wmdscjhdpy/SmartCar/README.md

# SmartCar
a project for a small intelligence Robot Car
