wmdscjhdpy/SmartCar/Doc/功能需求.docx

视觉：

边缘检测

人脸识别

判断车辆是否运行

判断摄像头是否有异物

简单的指点避障
