wmdscjhdpy/SmartCar/Doc/炸穿记录1.png

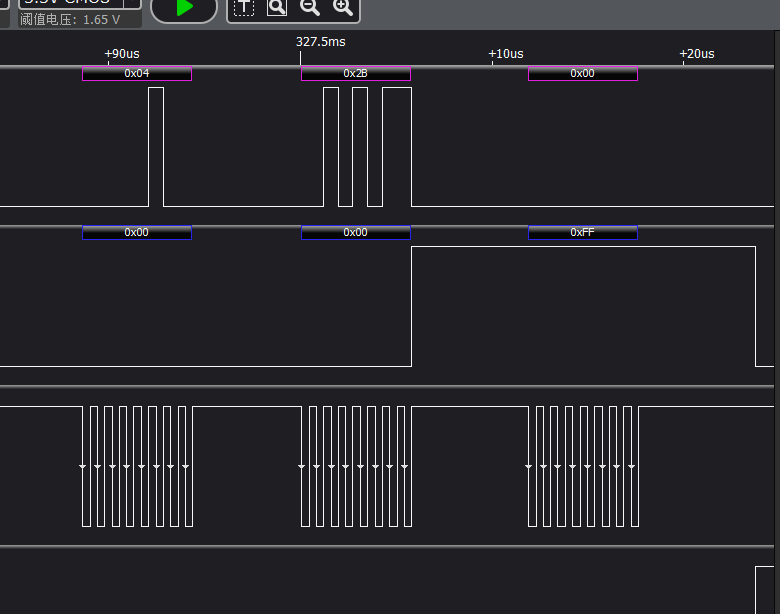
Doc/炸穿记录1.png
