wmdscjhdpy/SmartCar/Doc/SRT/oled大致模型.SLDPRT

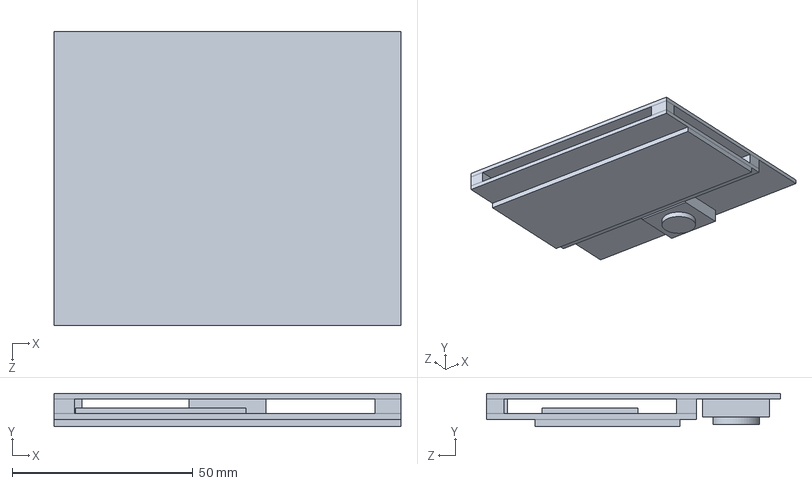
[picture p2: CAD file, 2019-03-22]
Doc/SRT/oled大致模型.SLDPRT
95.9 x 9.20 x 81.4 mm
