wmdscjhdpy/SmartCar/(list of files, drawings)

Other design files:
Doc/SRT/OLED&OPENMV.SchDoc
Doc/SRT/SRT.PrjPcb
Doc/SRT/主控.SchDoc
Doc/SRT/其他.SchDoc
Doc/SRT/电机,舵机.SchDoc
Doc/SRT/电机驱动.SchDoc
Doc/SRT/电源.SchDoc
Doc/SRT/语音合成.SchDoc
Doc/SRT/语音识别.SchDoc
