wmdscjhdpy/SmartCar/SmartCar.ioc

Mcu.UserName=STM32F405RGTx
PA0-WKUP.GPIO_Label=SIM_UART_TX
PA0-WKUP.Signal=GPIO_Output
PA1.GPIO_Label=SIM_UART_RX
PA1.Signal=GPIO_Input
PA13.Signal=SYS_JTMS-SWDIO
PA14.Signal=SYS_JTCK-SWCLK
PA15.GPIO_Label=LED4
PA15.Signal=GPIO_Output
PA2.GPIO_Label=STEERING1
PA2.Signal=S_TIM5_CH3
PA3.GPIO_Label=STEERING2
PA3.Signal=S_TIM5_CH4
PA4.GPIO_Label=SPI_NSS
PA4.Signal=GPIO_Output
PA5.Signal=SPI1_SCK
PA6.Signal=SPI1_MISO
PA7.Signal=SPI1_MOSI
PA8.Signal=S_TIM1_CH1
PA9.Signal=S_TIM1_CH2
PB0.Signal=S_TIM3_CH3
PB1.Signal=S_TIM3_CH4
PB3.GPIO_Label=SB_RST
PB3.Signal=GPIO_Output
PB5.GPIO_Label=BUSY
PB5.Signal=GPIO_Input
PB6.Signal=USART1_TX
PB7.Signal=USART1_RX
PB8.GPIO_Label=LED3
PB8.Signal=GPIO_Output
PC1.GPIO_Label=V_ADC
PC1.Signal=ADCx_IN11
PC10.Signal=USART3_TX
PC11.Signal=USART3_RX
PC12.GPIO_Label=IIC_SCL
PC12.Signal=GPIO_Output
PC13-ANTI_TAMP.GPIO_Label=LED1
PC13-ANTI_TAMP.Signal=GPIO_Output
PC14-OSC32_IN.GPIO_Label=LED2
PC14-OSC32_IN.Signal=GPIO_Output
PC2.GPIO_Label=ST_ADC1
PC2.Signal=ADCx_IN12
PC3.GPIO_Label=ST_ADC2
PC3.Signal=ADCx_IN13
PC4.GPIO_Label=LD_WR
PC4.Signal=GPIO_Output
PC6.Signal=S_TIM3_CH1
PC7.Signal=S_TIM3_CH2
PC8.Signal=S_TIM8_CH3
PC9.Signal=S_TIM8_CH4
PD2.GPIO_Label=IIC_SDA
PD2.Signal=GPIO_Output
PH0-OSC_IN.Signal=RCC_OSC_IN
PH1-OSC_OUT.Signal=RCC_OSC_OUT
