wmdscjhdpy/SmartCar/Inc/main.h

#define LED1_Pin GPIO_PIN_13
#define LED1_GPIO_Port GPIOC
#define LED2_Pin GPIO_PIN_14
#define LED2_GPIO_Port GPIOC
#define V_ADC_Pin GPIO_PIN_1
#define V_ADC_GPIO_Port GPIOC
#define ST_ADC1_Pin GPIO_PIN_2
#define ST_ADC1_GPIO_Port GPIOC
#define ST_ADC2_Pin GPIO_PIN_3
#define ST_ADC2_GPIO_Port GPIOC
#define SIM_UART_TX_Pin GPIO_PIN_0
#define SIM_UART_TX_GPIO_Port GPIOA
#define SIM_UART_RX_Pin GPIO_PIN_1
#define SIM_UART_RX_GPIO_Port GPIOA
#define STEERING1_Pin GPIO_PIN_2
#define STEERING1_GPIO_Port GPIOA
#define STEERING2_Pin GPIO_PIN_3
#define STEERING2_GPIO_Port GPIOA
#define SPI_NSS_Pin GPIO_PIN_4
#define SPI_NSS_GPIO_Port GPIOA
#define LD_WR_Pin GPIO_PIN_4
#define LD_WR_GPIO_Port GPIOC
#define LED4_Pin GPIO_PIN_15
#define LED4_GPIO_Port GPIOA
#define IIC_SCL_Pin GPIO_PIN_12
#define IIC_SCL_GPIO_Port GPIOC
#define IIC_SDA_Pin GPIO_PIN_2
#define IIC_SDA_GPIO_Port GPIOD
#define SB_RST_Pin GPIO_PIN_3
#define SB_RST_GPIO_Port GPIOB
#define BUSY_Pin GPIO_PIN_5
#define BUSY_GPIO_Port GPIOB
#define LED3_Pin GPIO_PIN_8
#define LED3_GPIO_Port GPIOB
