wmdscjhdpy/SmartCar/MyDrv/LD_Driver/LDChip.c

/***************************乐声电子科技有限公司****************************
**  文件名称：语音模块底层驱动
**	CPU: STM32f103RCT6
**	晶振：8MHZ
**	波特率：9600 bit/S
**	配套产品信息：YS-V0.4语音识别开发板
**                http://yuesheng001.taobao.com
**  作者：zdings
**  联系：751956552@qq.com
**  修改日期：2012.4.11
**  说明：本程序 具备语音识别、串口通信、开发板基本功能演示。
***************************乐声电子科技有限公司******************************/
#include "bsp.h"
#include "LDchip.h"
#include "Reg_RW.h"
#include "cmsis_os.h"
uint8_t nLD_Mode = LD_MODE_IDLE;		//	用来记录当前是在进行ASR识别还是在播放MP3
uint8_t nAsrStatus=0;	
uint8_t ucRegVal;


/***********************************************************
* 名    称：void LD_reset(void)
* 功    能：LD芯片硬件初始化
* 入口参数：  
* 出口参数：
* 说    明：因为硬件接口没有引出RST引脚，因此不能软件复位
* 调用方法： 
**********************************************************/ 
void LD_reset(void)
{
    LD_RST_H();
	LD3320_delay(100);
    LD_RST_L();
	LD3320_delay(100);
    LD_RST_H();
	LD3320_delay(100);
	LD_CS_L();
	LD3320_delay(100);
	LD_CS_H();		
	LD3320_delay(100);
}

/***********************************************************
* 名    称： void LD_Init_Common(void)
* 功    能： 初始化命令
* 入口参数：  
* 出口参数：
* 说    明：
* 调用方法： 
**********************************************************/ 
void LD_Init_Common(void)
{

	LD_ReadReg(0x06);  
	LD_WriteReg(0x17, 0x35); 
	LD3320_delay(5);
	LD_ReadReg(0x06);  

	LD_WriteReg(0x89, 0x03);  
	LD3320_delay(5);
	LD_WriteReg(0xCF, 0x43);   
	LD3320_delay(5);
	LD_WriteReg(0xCB, 0x02);
	
	/*PLL setting*/
	LD_WriteReg(0x11, LD_PLL_11);       
	if (nLD_Mode == LD_MODE_MP3)
	{
		LD_WriteReg(0x1E, 0x00); 
		LD_WriteReg(0x19, LD_PLL_MP3_19);   
		LD_WriteReg(0x1B, LD_PLL_MP3_1B);   
		LD_WriteReg(0x1D, LD_PLL_MP3_1D);
	}
	else
	{
		LD_WriteReg(0x1E,0x00);
		LD_WriteReg(0x19, LD_PLL_ASR_19); 
		LD_WriteReg(0x1B, LD_PLL_ASR_1B);		
	    LD_WriteReg(0x1D, LD_PLL_ASR_1D);
	}
	LD3320_delay(5);
	
	LD_WriteReg(0xCD, 0x04);
	LD_WriteReg(0x17, 0x4c); 
	LD3320_delay(1);
	LD_WriteReg(0xB9, 0x00);
	LD_WriteReg(0xCF, 0x4F); 
	LD_WriteReg(0x6F, 0xFF); 
}

/***********************************************************
* 名    称：void LD_Init_ASR(void)
* 功    能：初始化ASR
* 入口参数：  
* 出口参数：
* 说    明：
* 调用方法： 
**********************************************************/ 	
void LD_Init_ASR(void)
{
	nLD_Mode=LD_MODE_ASR_RUN;
	LD_Init_Common();

	LD_WriteReg(0xBD, 0x00);
	LD_WriteReg(0x17, 0x48);	
	LD3320_delay( 5 );
	LD_WriteReg(0x3C, 0x80);    
	LD_WriteReg(0x3E, 0x07);
	LD_WriteReg(0x38, 0xff);    
	LD_WriteReg(0x3A, 0x07);
	LD_WriteReg(0x40, 0);          
	LD_WriteReg(0x42, 8);
	LD_WriteReg(0x44, 0);    
	LD_WriteReg(0x46, 8); 
	LD3320_delay( 1 );
}

/***********************************************************
* 名    称：void ProcessInt0(void)
* 功    能：识别处理函数
* 入口参数：  
* 出口参数：
* 说    明：可以利用查询方式，或中断方式进行调用
* 调用方法： 
**********************************************************/ 
void ProcessInt0(void)
{
	uint8_t nAsrResCount=0;
    uint32_t ScanTime=HAL_GetTick();
    while(1)
    {
        
        if(nAsrStatus==LD_ASR_NONE)return;//还没有启动语音识别，就不存在识别了
        ucRegVal = LD_ReadReg(0x2B);

        // 语音识别产生的中断
        // （有声音输入，不论识别成功或失败都有中断）
        LD_WriteReg(0x29,0) ;
        LD_WriteReg(0x02,0) ;
        if((ucRegVal & 0x10) && LD_ReadReg(0xb2)==0x21 && LD_ReadReg(0xbf)==0x35)		
        {	 
            nAsrResCount = LD_ReadReg(0xba);

            if(nAsrResCount>0 && nAsrResCount<=4) 
            {
                nAsrStatus=LD_ASR_FOUNDOK; 		
                break;
            }
            else
            {
                nAsrStatus=LD_ASR_FOUNDZERO;
                if(HAL_GetTick()-ScanTime>2000)
                {
                    nAsrStatus=LD_ASR_NONE;
                    return;
                }
                osDelay(100);
            }	
        }
        else
         {
                nAsrStatus=LD_ASR_FOUNDZERO;	//执行没有识别
                osDelay(100);
        }
    }
		  LD_WriteReg(0x2b, 0);
		  LD_WriteReg(0x1C,0);/*写0:ADC不可用*/
		
			LD_WriteReg(0x29,0) ;
			LD_WriteReg(0x02,0) ;
			LD_WriteReg(0x2B,  0);
			LD_WriteReg(0xBA, 0);	
			LD_WriteReg(0xBC,0);	
			LD_WriteReg(0x08,1);	 /*清除FIFO_DATA*/
			LD_WriteReg(0x08,0);	/*清除FIFO_DATA后 再次写0*/

			//LD3320_delay(1);

}

/***********************************************************
* 名    称：uint8_t LD_Check_ASRBusyFlag_b2(void)
* 功    能：检测 ASR 是否忙状态
* 入口参数：flag ---1：空闲状态  
* 出口参数：
* 说    明：
* 调用方法： 
**********************************************************/ 
uint8_t LD_Check_ASRBusyFlag_b2(void)
{
	uint8_t j;
	uint8_t flag = 0;
	for (j=0; j<10; j++)
	{
		if (LD_ReadReg(0xb2) == 0x21)
		{
			flag = 1;
			break;
		}
		LD3320_delay(10);		
	}
	return flag;
}
/***********************************************************
* 名    称： void LD_AsrStart(void)
* 功    能：
* 入口参数：  ASR初始化
* 出口参数：
* 说    明：
* 调用方法： 
**********************************************************/ 
void LD_AsrStart(void)
{
	LD_Init_ASR();
}
/***********************************************************
* 名    称： uint8_t LD_AsrRun(void)
* 功    能： ASR底层执行函数 
* 入口参数：  
* 出口参数：
* 说    明：
* 调用方法： 
**********************************************************/ 
uint8_t LD_AsrRun(void)
{
	LD_WriteReg(0x35, MIC_VOL);
	LD_WriteReg(0x1C, 0x09);
	LD_WriteReg(0xBD, 0x20);
	LD_WriteReg(0x08, 0x01);
	LD3320_delay( 5 );
	LD_WriteReg(0x08, 0x00);
	LD3320_delay( 5);

	if(LD_Check_ASRBusyFlag_b2() == 0)
	{
		return 0;
	}

	LD_WriteReg(0xB2, 0xff);	
	LD_WriteReg(0x37, 0x06);
	LD_WriteReg(0x37, 0x06);
	LD3320_delay( 5);
	LD_WriteReg(0x1C, 0x0b);
	LD_WriteReg(0x29, 0x10);
	
	LD_WriteReg(0xBD, 0x00);   
	return 1;
}

/***********************************************************
* 名    称：uint8_t LD_AsrAddFixed(void)
* 功    能：添加识别关键词语
* 入口参数：  
* 出口参数： flag-- 1：success
* 说    明：开发者可以学习"语音识别芯片LD3320高阶秘籍.pdf"中
						关于垃圾词语吸收错误的用法，提高识别率。
* 调用方法： 
**********************************************************/ 
uint8_t LD_AsrAddFixed(void)
{
	uint8_t k, flag;
	uint8_t nAsrAddLength;
	#define DATE_A 4        /*数组二维数值*/
	#define DATE_B 20		/*数组一维数值*/
	 uint8_t  sRecog[DATE_A][DATE_B] = {
                                    "feng shuo",\
                                    "kai deng",\
                                    "guan deng",\
                                    "quan mie"\
                                    };	/*添加关键词，用户修改*/
	 uint8_t  pCode[DATE_A] = {
                                        CODE_CMD,\
                                        CODE_KD,\
                                         CODE_GD,\
                                          CODE_QM\
                                    };	/*添加识别码，用户修改*/
	flag = 1;
	for (k=0; k<DATE_A; k++)
	{			
		if(LD_Check_ASRBusyFlag_b2() == 0)
		{
			flag = 0;
			break;
		}
		
		LD_WriteReg(0xc1, pCode[k] );
		LD_WriteReg(0xc3, 0 );
		LD_WriteReg(0x08, 0x04);
		LD3320_delay(1);
		LD_WriteReg(0x08, 0x00);
		LD3320_delay(1);

		for (nAsrAddLength=0; nAsrAddLength<DATE_B; nAsrAddLength++)
		{
			if (sRecog[k][nAsrAddLength] == 0)
				break;
			LD_WriteReg(0x5, sRecog[k][nAsrAddLength]);
		}
		LD_WriteReg(0xb9, nAsrAddLength);
		LD_WriteReg(0xb2, 0xff);
		LD_WriteReg(0x37, 0x04);
//		LD_WriteReg(0x37, 0x04);
	}	 

    return flag;
}

/***********************************************************
* 名    称： uint8_t LD_GetResult(void)
* 功    能： 获取识别结果
* 入口参数：  
* 出口参数： 返回识别码 LD_ReadReg(0xc5 );
* 说    明：
* 调用方法： 
**********************************************************/ 
uint8_t LD_GetResult(void)
{
	return LD_ReadReg(0xc5 );
}



/***********************************************************
* 名    称：	RunASR(void)
* 功    能：	运行ASR
* 入口参数：  
* 出口参数：
* 说    明：
* 调用方法： 
**********************************************************/ 
uint8_t RunASR(void)
{
	uint8_t i=0;
	uint8_t asrflag=0;
	for (i=0; i<5; i++)			//	防止由于硬件原因导致LD3320芯片工作不正常，所以一共尝试5次启动ASR识别流程
	{
		LD_AsrStart();			//初始化ASR
		LD3320_delay(100);
		if (LD_AsrAddFixed()==0)	//添加关键词语到LD3320芯片中
		{
			LD_reset();			//	LD3320芯片内部出现不正常，立即重启LD3320芯片
			LD3320_delay(50);			//	并从初始化开始重新ASR识别流程
			continue;
		}

		LD3320_delay(10);

		if (LD_AsrRun() == 0)
		{
			LD_reset();			//	LD3320芯片内部出现不正常，立即重启LD3320芯片
			LD3320_delay(50);			//	并从初始化开始重新ASR识别流程
			continue;
		}

		asrflag=1;
		break;					//	ASR流程启动成功，退出当前for循环。开始等待LD3320送出的中断信号
	}

	return asrflag;
}
