wmdscjhdpy/SmartCar/Inc/bsp.h

#ifndef BSP_H
#define BSP_H

#include "stm32f4xx_hal.h"
#include "uart_esp.h"
#include "UART_MV.h"
#include "tim.h"
#include "adc.h"
#include "spi.h"
#include "cmsis_os.h"
#include "voice.h"
#include "LDchip.h"
#include "Reg_RW.h"
#include "iic_oled.h"
#define ADC_BUF_NUM 30

extern float Battery_V;
extern uint16_t Distance0;//红外对管1的电压值
extern uint16_t Distance1;//红外对管2的电压值

void BSP_Init(void);
void ADC_Handler(void);
void Car_Move(float forward,float sita);
//通用宏定义
#define ABS(x) ((x)>0?(x):-(x))
#define SIGN(x) ((x)/ABS(x))
#define LIMIT(x,l) (ABS(x)>(l)?SIGN(x)*(l):(x))
#define LED(num,value) HAL_GPIO_WritePin(LED##num##_GPIO_Port,LED##num##_Pin,(GPIO_PinState)value);
//车辆运动驱动宏定义，速度定义为0-1000
#define RIGHT_FORWARD(x) __HAL_TIM_SetCompare(&htim3,TIM_CHANNEL_1,0);__HAL_TIM_SetCompare(&htim3,TIM_CHANNEL_2,x)
#define RIGHT_REVERSE(x) __HAL_TIM_SetCompare(&htim3,TIM_CHANNEL_2,0);__HAL_TIM_SetCompare(&htim3,TIM_CHANNEL_1,x)
#define RIGHT_Break __HAL_TIM_SetCompare(&htim3,TIM_CHANNEL_2,1000);__HAL_TIM_SetCompare(&htim3,TIM_CHANNEL_1,1000)

#define LEFT_FORWARD(x) __HAL_TIM_SetCompare(&htim3,TIM_CHANNEL_3,0);__HAL_TIM_SetCompare(&htim3,TIM_CHANNEL_4,x)
#define LEFT_REVERSE(x) __HAL_TIM_SetCompare(&htim3,TIM_CHANNEL_4,0);__HAL_TIM_SetCompare(&htim3,TIM_CHANNEL_3,x)
#define LEFT_Break __HAL_TIM_SetCompare(&htim3,TIM_CHANNEL_3,1000);__HAL_TIM_SetCompare(&htim3,TIM_CHANNEL_4,1000)

//头部定义 前进方向编码器增加
#define HEAD_FORWARD(x) __HAL_TIM_SetCompare(&htim8,TIM_CHANNEL_3,0);__HAL_TIM_SetCompare(&htim8,TIM_CHANNEL_4,x)
#define HEAD_REVERSE(x) __HAL_TIM_SetCompare(&htim8,TIM_CHANNEL_4,0);__HAL_TIM_SetCompare(&htim8,TIM_CHANNEL_3,x)
#define HEAD_Break __HAL_TIM_SetCompare(&htim8,TIM_CHANNEL_3,1000);__HAL_TIM_SetCompare(&htim8,TIM_CHANNEL_4,1000)

//综合正负号的电机操作
#define MECH_RUN(name,value) {\
    if(value>0){name##_FORWARD(LIMIT(value,1000));}else if(value<0){name##_REVERSE(LIMIT(value,1000));}else{ name##_Break;}\
}
//手部定义 输入值应为500-2500 当前确定的范围为750-1300
#define HAND_SET(x) __HAL_TIM_SetCompare(&htim5,TIM_CHANNEL_3,x)
#define HAND_UP HAND_SET(1300)
#define HAND_DOWN HAND_SET(750)
typedef struct {
    int HeadTargetEnc;
    int HeadRealEnc;
    int HeadTargetCurrent;
    int action_priority;//事件优先级，优先级高的会抢占优先级低的时间 可以用线程优先级来解决？
}car_t;
extern car_t car;
#endif
