wmdscjhdpy/SmartCar/Src/bsp_action.c

/** 
* @file	   bsp_action.c
* @brief    板级的机器人动作文件
* @details  决定每一个具体的触发事件 事件和
* @author   WMD
* @date     2019年4月18日21:32:47
* @version  0.1
* @par Copyright (c):  
*       WMD 
* @par 日志
*/  
#include "bsp.h"
