wmdscjhdpy/SmartCar/MyDrv/iic_oled_stable_V4.2/iic_oled.h

#ifndef IIC_OLED
#define IIC_OLED
#include "stm32f4xx_hal.h"//根据具体型号自行更改引用文件


typedef struct
{
	uint8_t x;
	uint8_t y;
}point;//定义结构体以返回末尾坐标


#ifdef OLED_PUTC  //假如启用OLED重定向到printf
int fputc(int ch, FILE *f);
//此处建议有两个定义 来开启printf刷新和关闭printf刷新
#define EA_OLED __HAL_TIM_ENABLE_IT(&htim2,TIM_IT_UPDATE)
#define DA_OLED __HAL_TIM_DISABLE_IT(&htim2,TIM_IT_UPDATE)



#endif
uint8_t OLED_Init(void);
void OLED_ON(void);
void OLED_SetPos(unsigned char x, unsigned char y);
void OLED_Fill(unsigned char fill_Data);
void OLED_CLS(void);
point OLED_ShowStr(unsigned char x, unsigned char y, unsigned char ch[], unsigned char TextSize);
void OLED_OPEN_SCREEN(void);

#endif
