wmdscjhdpy/SmartCar/(commit log)

2019-01-05 因为onedrive的版本库好像丢了 因此这就算第一次提交吧不过其实改变了很多东西，比如语音合成芯片使用模拟串口了
2019-01-13 增加了电池电压采样和红外对管采样的功能
2019-01-14 添加LD3320代码，还未移植完成
2019-01-14 成功写完语音合成驱动
2019-01-14 移植语音识别模块完成，虽然没能成功跑起来，但是感觉软件逻辑是对的
2019-01-20 改编版本能够成功完成语音识别，但是语音识别有时候会假死
2019-01-20 增加代码鲁棒性 在长时间识别失败后将进行复位
2019-01-22 增加了openmv的通讯协议，画了下流程图
2019-03-22 根据硬件电路图增加软件插线笔记 应用底盘代码以确定电机方向 加入硬件电路图以便查找
    [OLED&OPENMV.SchDoc, SRT.PrjPcb, oled大致模型.SLDPRT, 主控.SchDoc, 交互场景表.xlsx, 其他.SchDoc, 电机,舵机.SchDoc, 电机驱动.SchDoc]
2019-04-17 头部目前能够正常运行 加入了开机动作逻辑，确认语音合成正常工作了
    [工作时间线.xlsx]
2019-04-18 准备视觉驱动 现在机械上大部分东西都ok了 虽然还有很多小问题
    [工作时间线.xlsx]
2019-04-19 制定了通信协议 并完成基础实践 可以说是所有基本硬件功能都完成了
2019-06-26 最后一次转手的提交
    [工作时间线.xlsx]
