wmdscjhdpy/SmartCar/(notices)

Notices in the files:
MyDrv/LD_Driver/Reg_RW.h:
°æÈ¨ËùÓÐ£ºCopyright (c) 2005 - 2010 ICRoute INC.
Inc/main.h:
Copyright (c) 2019 STMicroelectronics International N.V.
All rights reserved.
(C) COPYRIGHT STMicroelectronics *****END OF FILE
